CornetPrisme/PCB-Thermometer/production/Thermometer_bom.csv

Designator | Footprint | Quantity | Value | LCSC Part #
C1, C5 | 0603 | 2 | 1u | C15849
C2 | 1206 | 1 | 22u | C12891
C3, C4, C7 | 0603 | 3 | 0u1 | C14663
C6 | 0603 | 1 | 10u | C19702
C8 | 0603 | 1 | 0u01 | C57112
D1, D2 | D_SMA | 2 | D_Schottky | C22452
J1, J2 | JST_XH_B3B-XH-A_1x03_P2.50mm_Vertical | 2 | Conn_01x03_Socket
J4 | USB_C_Receptacle_HRO_TYPE-C-31-M-12 | 1 | USB_C_Receptacle_USB2.0_14P | C393939
J5 | JST_XH_B2B-XH-A_1x02_P2.50mm_Vertical | 1 | Conn_01x02
R1, R10, R2, R3, R6, R7 | 0603 | 6 | 10k | C25804
R4, R5 | 0603 | 2 | 22 | C23345
R8, R9 | 0603 | 2 | 5k1 | C23186
SW1, SW2 | SW_SPST_TS-1088-xR025 | 2 | SW_Push | C720477
U1 | ESP32-C6-WROOM-1 | 1 | ESP32-C6-WROOM-1 | C5366877
U2 | Texas_S-PWSON-N6-HDC2080 | 1 | HDC2080 | C918141
U3 | SOIC-8_3.9x4.9mm_P1.27mm | 1 | LM75B | C725792
U4 | SOT-23-5 | 1 | TLV75733PDBV | C485517
U5 | SOT-563 | 1 | TMP102xxDRL | C99269
U6 | SOT-23-6 | 1 | USBLC6-2SC6 | C7519
