CornetPrisme/PCB-Thermometer/Thermometer.kicad_pcb

## KiCad design Thermometer.kicad_pcb (2026-10-13)

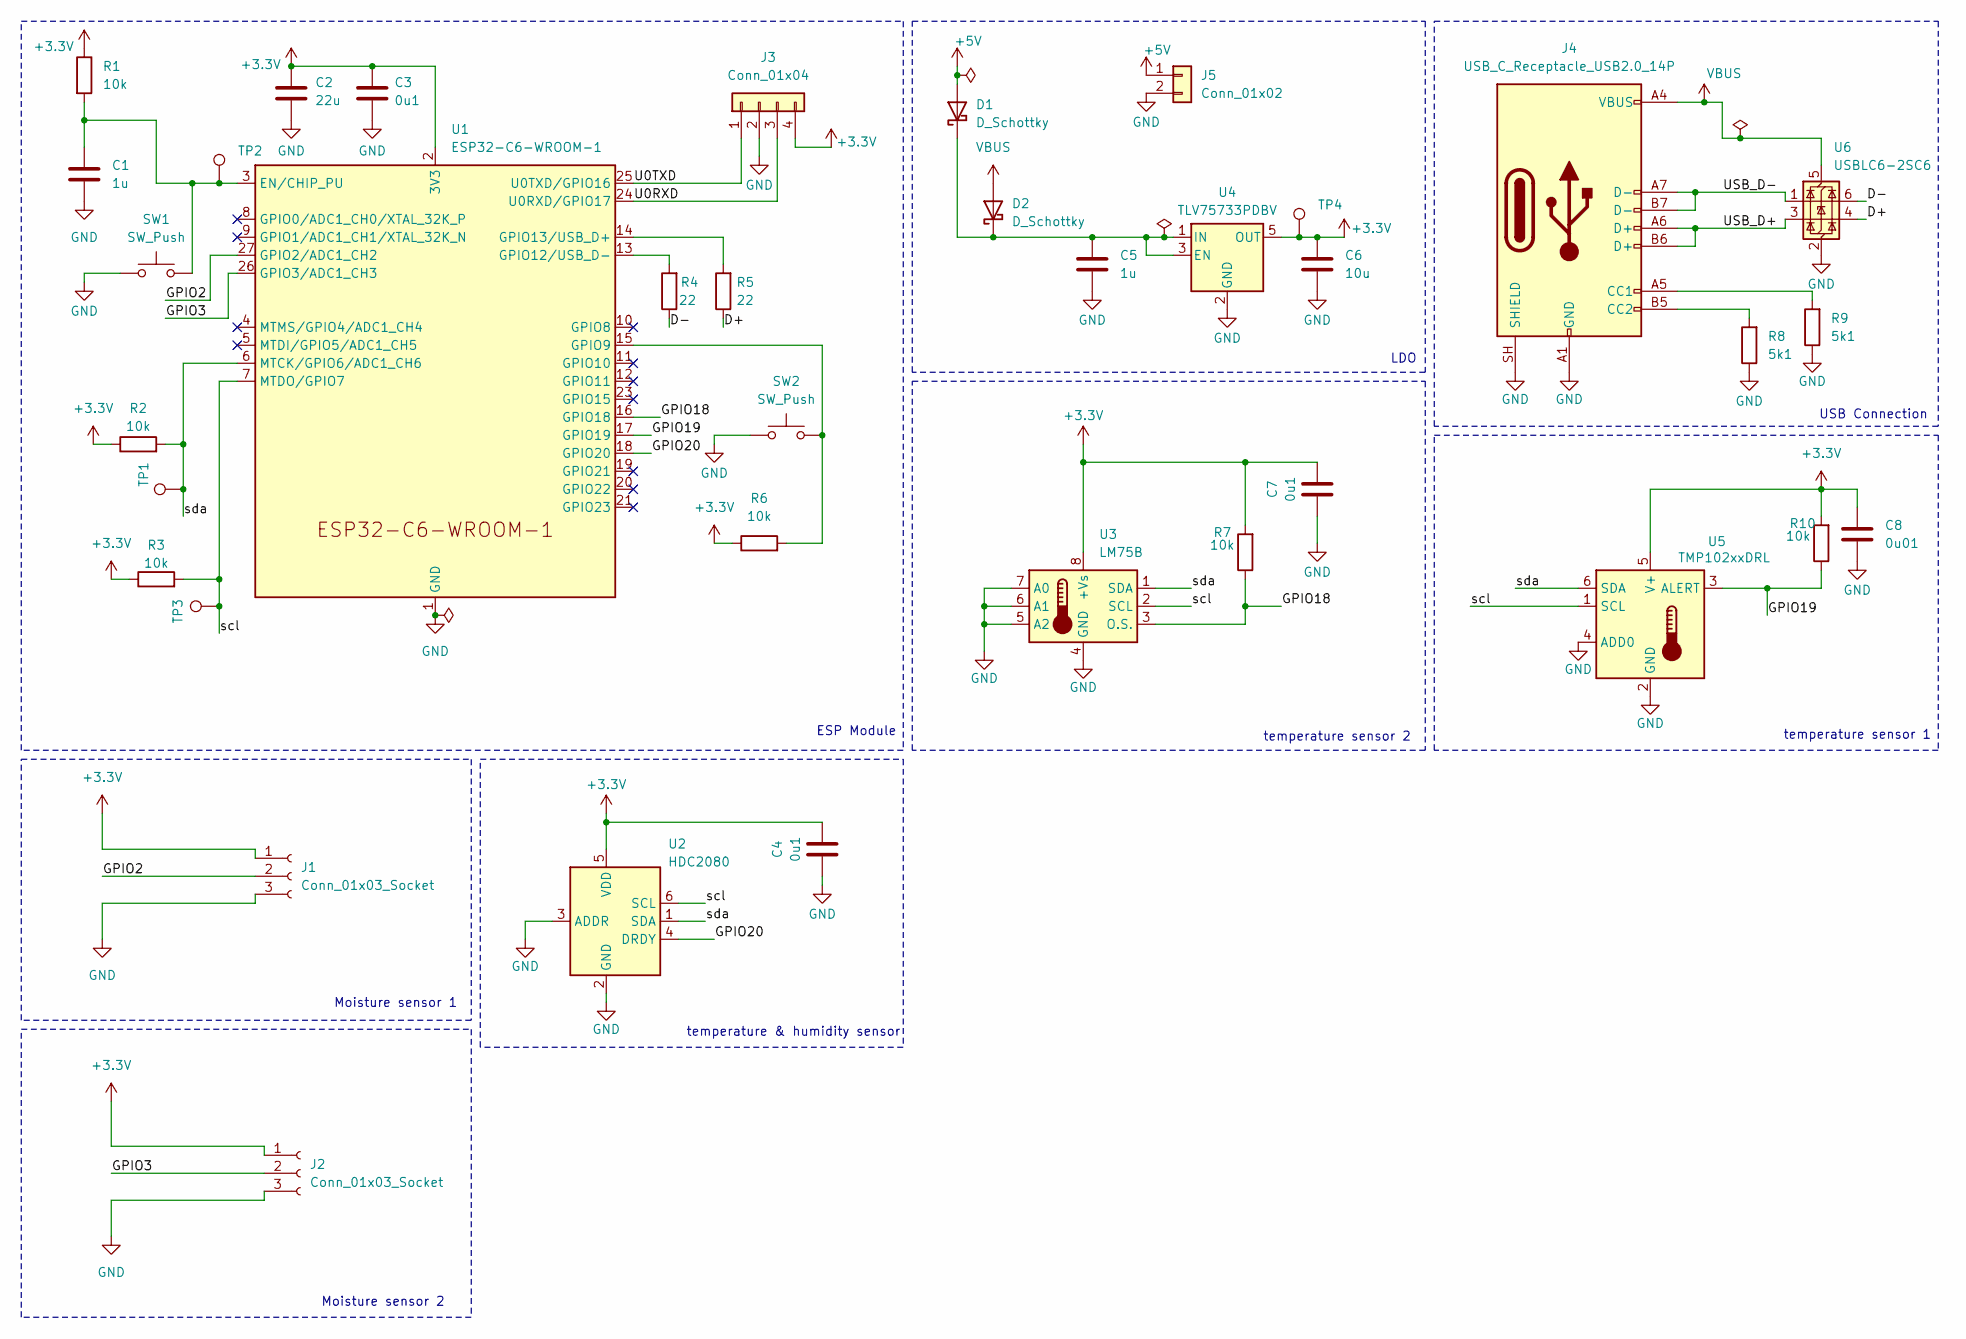
[picture p1: schematic Thermometer.kicad_sch, Thermometer PCB]

Parts:
C1, C5: 1u; C_0603_1608Metric; Manufacturer Part Number CL10A105KB8NNNC; JLCPCB Part # C15849
C2: 22u; C_1206_3216Metric; Manufacturer Part Number CL31A226KAHNNNE; JLCPCB Part # C12891
C3, C4, C7: 0u1; C_0603_1608Metric; Manufacturer Part Number CC0603KRX7R9BB104; JLCPCB Part # C14663
C6: 10u; C_0603_1608Metric; Manufacturer Part Number CL10A106KP8NNNC; JLCPCB Part # C19702
C8: 0u01; C_0603_1608Metric; Manufacturer Part Number 0603B103K500NT; JLCPCB Part # C57112
D1, D2: D_Schottky; D_SMA; Manufacturer Part Number SS54; JLCPCB Part # C22452
J1, J2: Conn_01x03_Socket; JST_XH_B3B-XH-A_1x03_P2.50mm_Vertical
J3: Conn_01x04; PinHeader_1x04_P2.54mm_Vertical
J4: USB_C_Receptacle_USB2.0_14P; USB_C_Receptacle_HRO_TYPE-C-31-M-12; Manufacturer Part Number TYPE-C16PIN; JLCPCB Part # C393939
J5: Conn_01x02; JST_XH_B2B-XH-A_1x02_P2.50mm_Vertical
R1, R2, R3, R6, R7, R10: 10k; R_0603_1608Metric; Manufacturer Part Number 0603WAF1002T5E; JLCPCB Part # C25804
R4, R5: 22; R_0603_1608Metric; Manufacturer Part Number 0603WAF220JT5E; JLCPCB Part # C23345
R8, R9: 5k1; R_0603_1608Metric; Manufacturer Part Number 0603WAF5101T5E; JLCPCB Part # C23186
SW1, SW2: SW_Push; SW_SPST_TS-1088-xR025; Manufacturer Part Number TS-1088-AR02016; JLCPCB Part # C720477
TP1, TP2, TP3, TP4: TestPoint; TestPoint_Pad_D3.0mm
U1: ESP32-C6-WROOM-1; Manufacturer Part Number ESP32-C6-WROOM-1-N8; JLCPCB Part # C5366877
U2: HDC2080; Texas_S-PWSON-N6-HDC2080; Manufacturer Part Number HDC2080DMBR; JLCPCB Part # C918141
U3: LM75B; SSOP-8_3.9x5.05mm_P1.27mm; Manufacturer Part Number LM75BD(UMW); JLCPCB Part # C725792
U4: TLV75733PDBV; SOT-23-5; Manufacturer Part Number TLV75733PDBVR; JLCPCB Part # C485517
U5: TMP102xxDRL; SOT-563; Manufacturer Part Number TMP102AIDRLR; JLCPCB Part # C99269
U6: USBLC6-2SC6; SOT-23-6; Manufacturer Part Number USBLC6-2SC6; JLCPCB Part # C7519

Connections:
+3.3V: C2.1, C3.1, C4.2, C6.1, C7.2, C8.1, J1.1, J2.1, J3.4, R1.1, R2.1, R3.1, R6.1, R7.2, R10.2, TP4.1 (1_1), U1.2 (3V3), U2.5 (VDD), U3.8 (+Vs), U4.5 (OUT), U5.5 (V+)
+5V: D1.2 (A), J5.1
/D+: R5.1, U6.4 (I/O2)
/D-: R4.1, U6.6 (I/O1)
/GPIO2: J1.2, U1.27 (GPIO2/ADC1_CH2)
/GPIO3: J2.2, U1.26 (GPIO3/ADC1_CH3)
/GPIO18: R7.1, U1.16 (GPIO18), U3.3 (O.S.)
/GPIO19: R10.1, U1.17 (GPIO19), U5.3 (ALERT)
/GPIO20: U1.18 (GPIO20), U2.4 (DRDY)
/U0RXD: J3.3, U1.24 (U0RXD/GPIO17)
/U0TXD: J3.1, U1.25 (U0TXD/GPIO16)
/USB_D+: J4.A6 (D+), J4.B6 (D+), U6.3 (I/O2)
/USB_D-: J4.A7 (D-), J4.B7 (D-), U6.1 (I/O1)
/scl: R3.2, TP3.1 (1_1), U1.7 (MTDO/GPIO7), U2.6 (SCL), U3.2 (SCL), U5.1 (SCL)
/sda: R2.2, TP1.1 (1_1), U1.6 (MTCK/GPIO6/ADC1_CH6), U2.1 (SDA), U3.1 (SDA), U5.6 (SDA)
GND: C1.2, C2.2, C3.2, C4.1, C5.2, C6.2, C7.1, C8.2, J1.3, J2.3, J3.2, J4.A1 (GND), J4.A12 (GND), J4.B1 (GND), J4.B12 (GND), J4.SH (SHIELD), J5.2, R8.1, R9.1, SW1.1, SW2.1, U1.1 (GND), U1.28 (GND), U1.29 (GND), U2.2 (GND), U2.3 (ADDR), U3.4 (GND), U3.5 (A2), U3.6 (A1), U3.7 (A0), U4.2 (GND), U5.2 (GND), U5.4 (ADD0), U6.2 (GND)
unnamed: C5.1, D1.1 (K), D2.1 (K), U4.1 (IN), U4.3 (EN)
unnamed: J4.A5 (CC1), R9.2
unnamed: J4.B5 (CC2), R8.2
unnamed: C1.1, R1.2, SW1.2, TP2.1 (1_1), U1.3 (EN/CHIP_PU)
unnamed: R6.2, SW2.2, U1.15 (GPIO9)
unnamed: R4.2, U1.13 (GPIO12/USB_D-)
unnamed: R5.2, U1.14 (GPIO13/USB_D+)
VBUS: D2.2 (A), J4.A4 (VBUS), J4.A9 (VBUS), J4.B4 (VBUS), J4.B9 (VBUS), U6.5 (VBUS)

Notes on the sheet:
Moisture sensor 1
USB Connection
temperature & humidity sensor
ESP Module
Moisture sensor 2
temperature sensor 1
temperature sensor 2
LDO

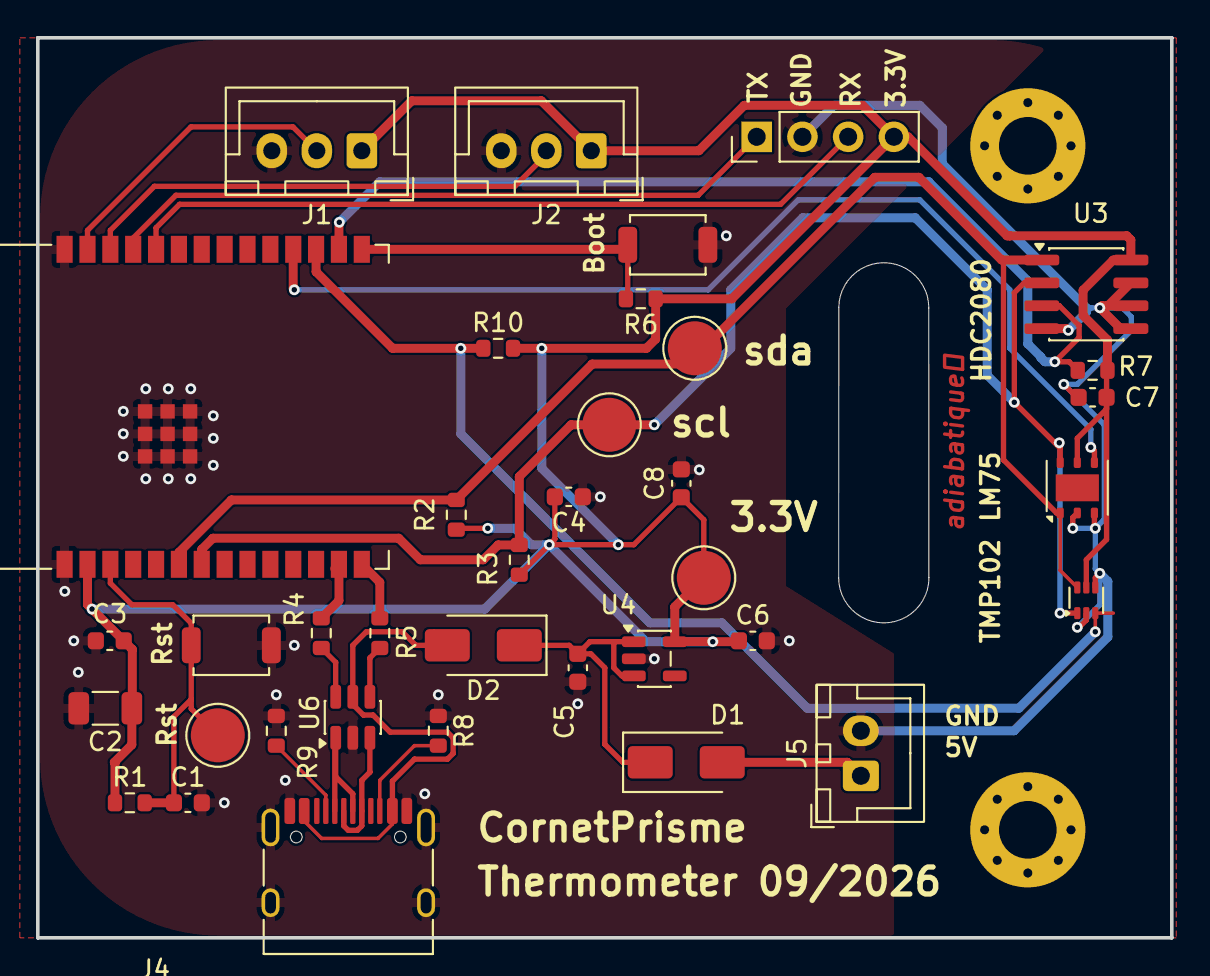
[picture p2: board Thermometer.kicad_pcb from above]

Board: 2 copper layers, 63.0 x 50.0 mm, 37 parts (0 on the bottom side), 24 nets.
