CornetPrisme/PCB-Thermometer/(commit log)

2026-09-21 second commit
    [Thermometer.kicad_pcb, Thermometer.kicad_sch]
2026-09-21 thrid commit
    [Thermometer.kicad_pcb]
2026-09-23 ajout des fichiers de production
    [Thermometer.kicad_pcb, Thermometer.kicad_sch, bom.csv, designators.csv, positions.csv]
2026-09-24 changement de disposition
    [Thermometer.kicad_pcb, Thermometer_bom.csv, Thermometer_designators.csv, Thermometer_positions.csv]
2026-09-28 Ajout image
    [Thermometer.kicad_pcb]
2026-10-13 changement Footprint U3
    [Thermometer.kicad_sch]
2026-10-13 changement fichiers prod
    [Thermometer_designators.csv]
2026-10-13 changement fichiers production
    [Thermometer.kicad_pcb, Thermometer_bom.csv, Thermometer_positions.csv]
2026-10-27 PCB Final
    [Thermometer.kicad_sch]
2026-10-27 Add README for ESP32-C6 Temperature and Humidity Sensors
    Added detailed information about the ESP32-C6 environmental sensor node, including components, previews, and code snippets.
